Shimmer233/2026NUEDC-H/视觉/orangepi5b_vision_only/config/track_calibration.reference.jpg

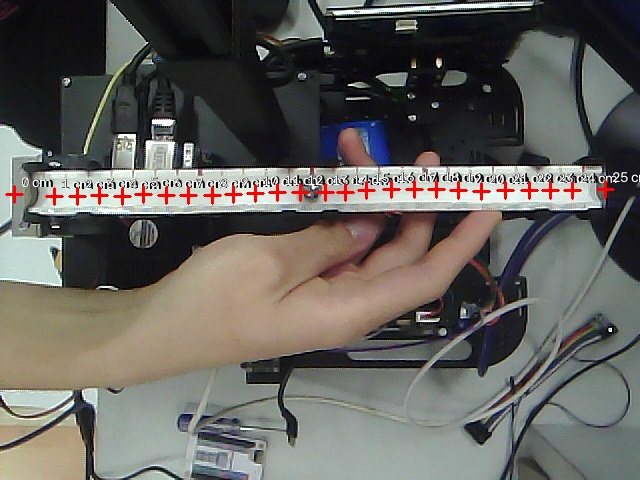
视觉/orangepi5b_vision_only/config/track_calibration.reference.jpg
