Shimmer233/2026NUEDC-H/README.md

# 2026NUEDC-H
2026年全国大学生电子设计竞赛H题的实现方案，包含结构文件，单片机程序，视觉程序
