Shimmer233/2026NUEDC-H/视觉/orangepi5b_vision_only/board/requirements-board.txt

numpy>=1.24,<2.0
opencv-python>=4.8
PyYAML>=6.0
# Install the supplied Rockchip RKNNLite wheel separately on RK3588/aarch64.
