Shimmer233/2026NUEDC-H/程序/README.txt

xunxian_1_new_drive_only_motor.zip 是控制循迹底盘的3507的程序
xunxian_1_new_drive_8_2_23.zip 是控制步进电机的3507的程序
