Shimmer233/2026NUEDC-H/005H038/c96c47cec39e12cd0c512a1ca953ea7d.jpg

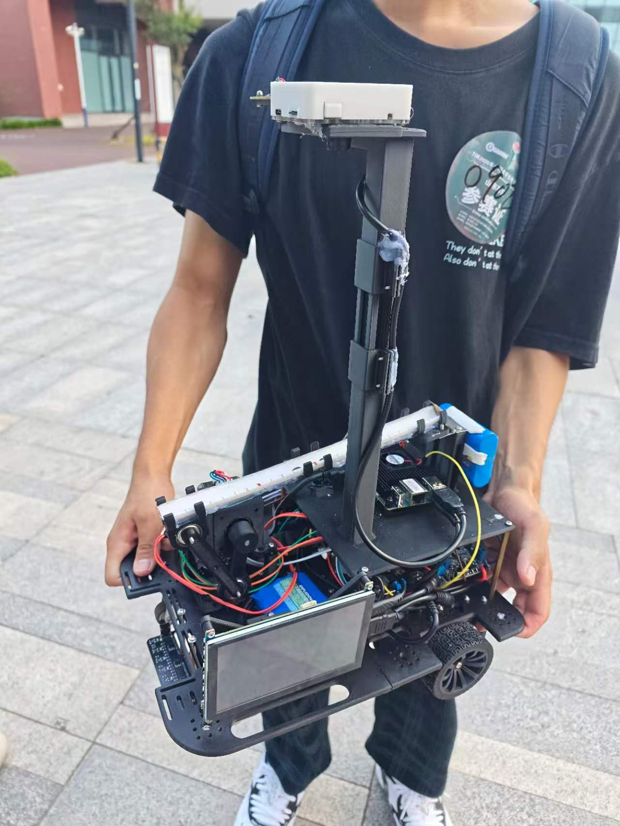
005H038/c96c47cec39e12cd0c512a1ca953ea7d.jpg
