Shimmer233/2026NUEDC-H/视觉/steel_ball_pipeline/artifacts/yolov5n/PR_curve.png

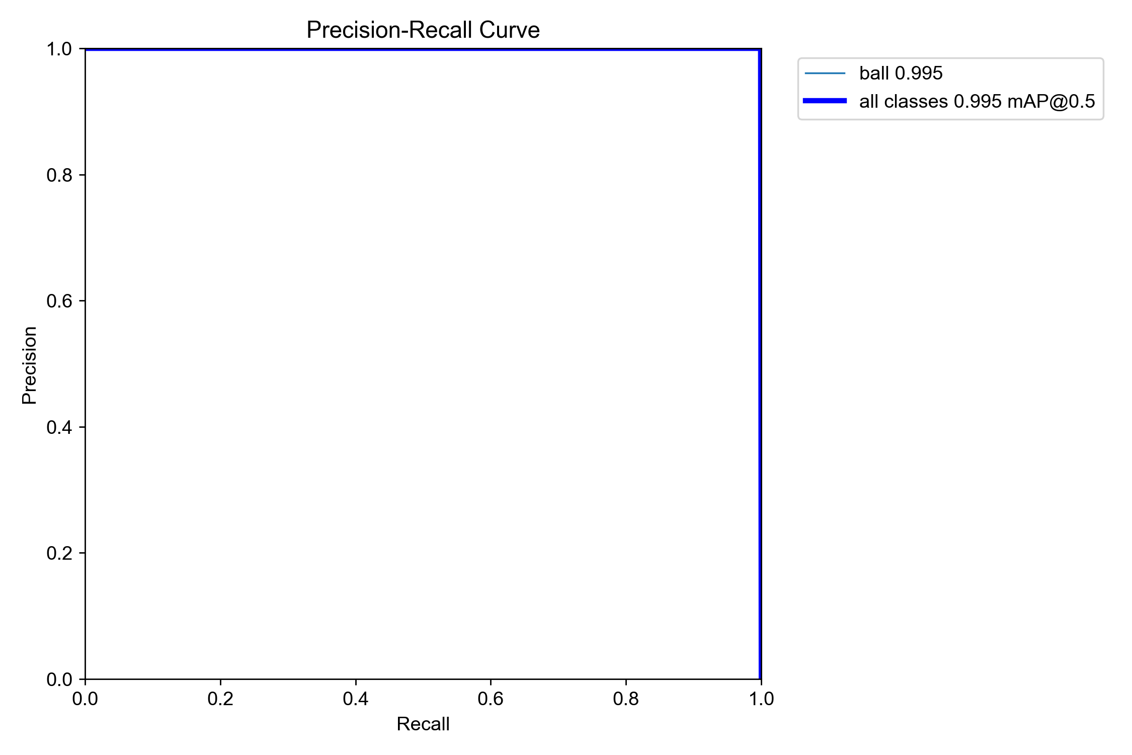
视觉/steel_ball_pipeline/artifacts/yolov5n/PR_curve.png
