Shimmer233/2026NUEDC-H/视觉/steel_ball_pipeline/artifacts/yolov5n_v4_incremental/video_regression/worst_ball_frames.jpg

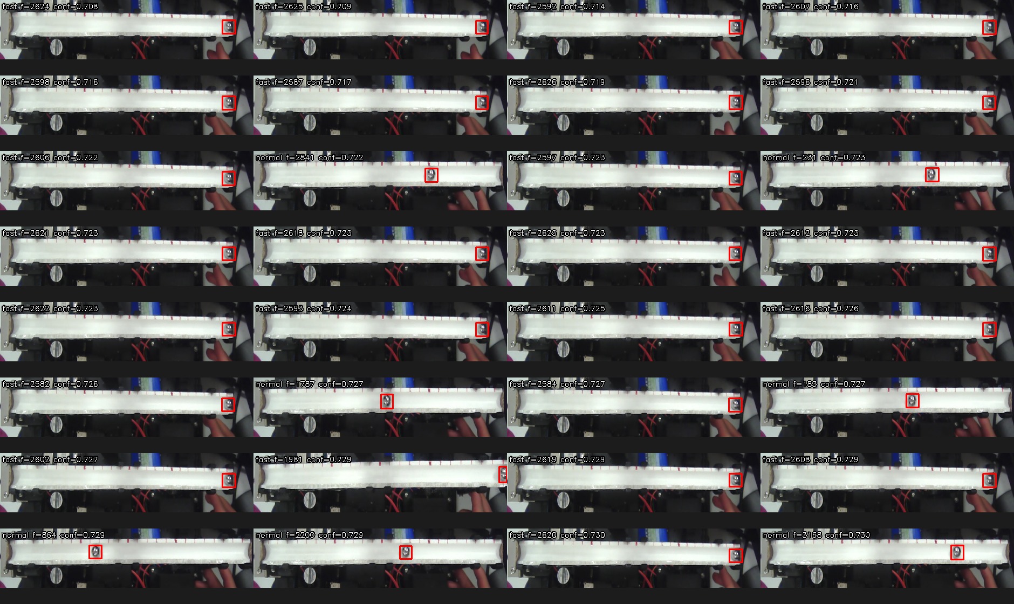
视觉/steel_ball_pipeline/artifacts/yolov5n_v4_incremental/video_regression/worst_ball_frames.jpg
