Shimmer233/2026NUEDC-H/视觉/steel_ball_pipeline/runs/final_acceptance_yolov5n_adapted_v3_480x320/worst_ball_frames.jpg

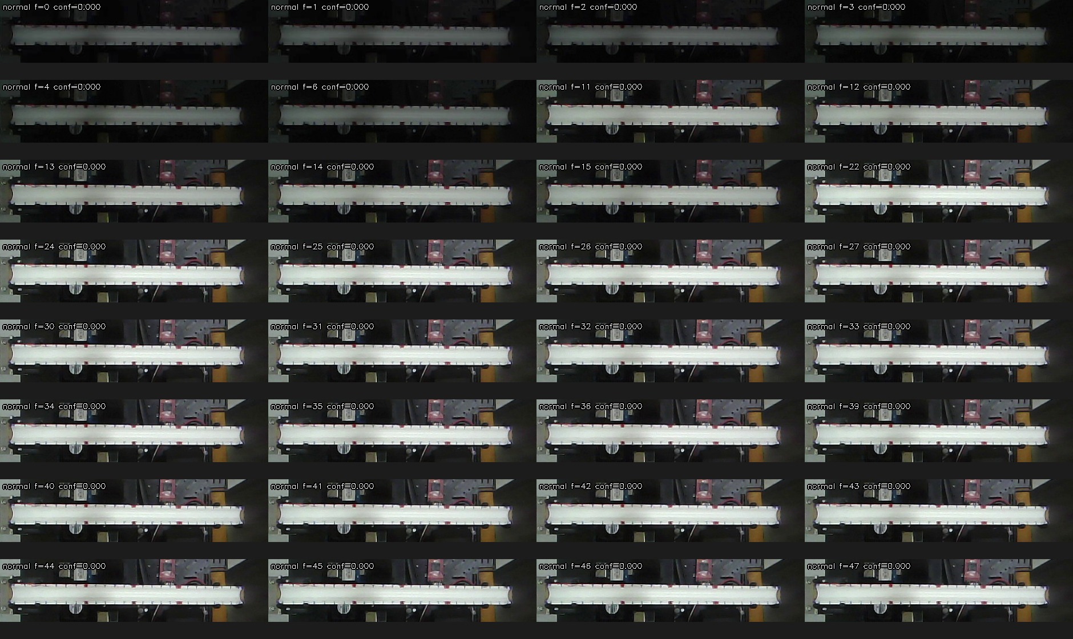
视觉/steel_ball_pipeline/runs/final_acceptance_yolov5n_adapted_v3_480x320/worst_ball_frames.jpg
