Shimmer233/2026NUEDC-H/视觉/steel_ball_pipeline/runs/train/steel_ball_yolov5n_seed42_20260731_002451/confusion_matrix.png

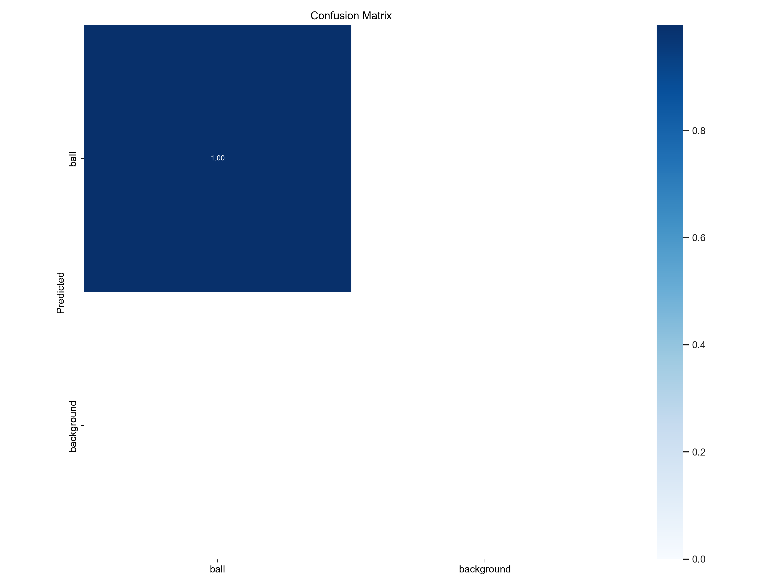
视觉/steel_ball_pipeline/runs/train/steel_ball_yolov5n_seed42_20260731_002451/confusion_matrix.png
