Shimmer233/2026NUEDC-H/视觉/steel_ball_pipeline/runs/train/steel_ball_yolov5n_seed42_20260731_012030/labels.jpg

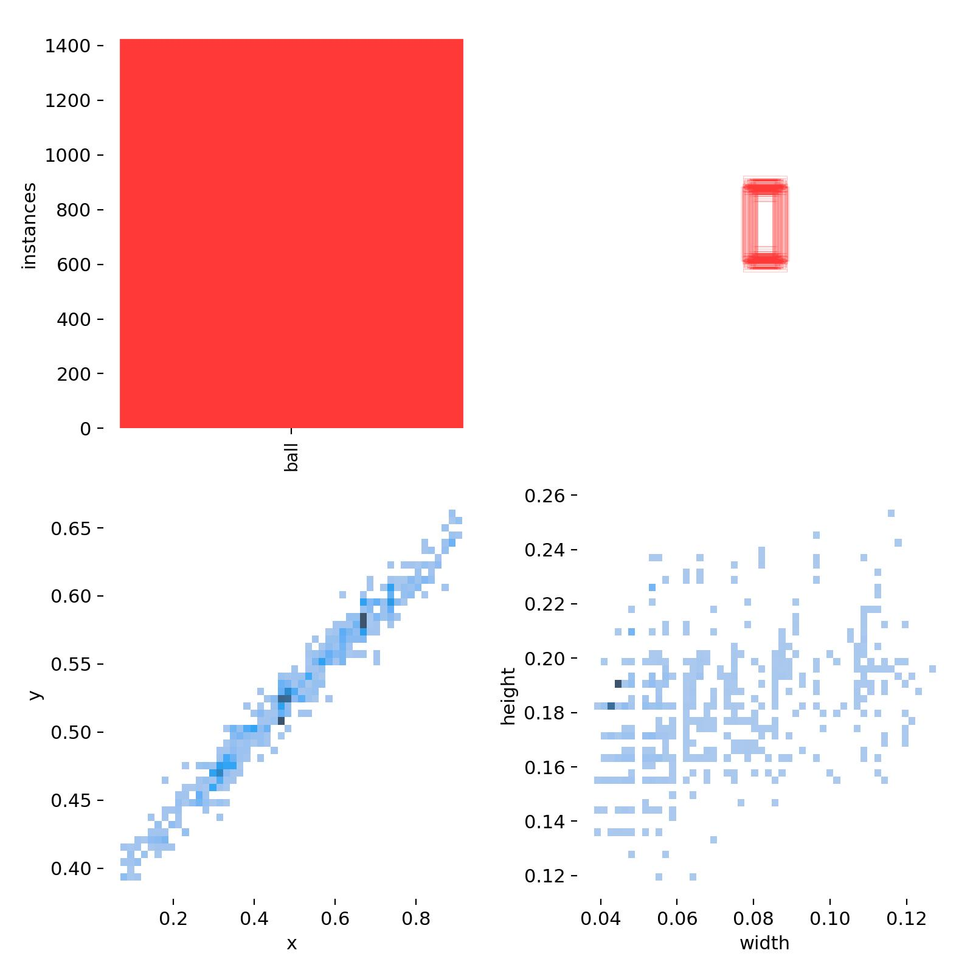
视觉/steel_ball_pipeline/runs/train/steel_ball_yolov5n_seed42_20260731_012030/labels.jpg
