Shimmer233/2026NUEDC-H/视觉/steel_ball_pipeline/runs/train/steel_ball_yolov5n_v4_incremental_seed42/F1_curve.png

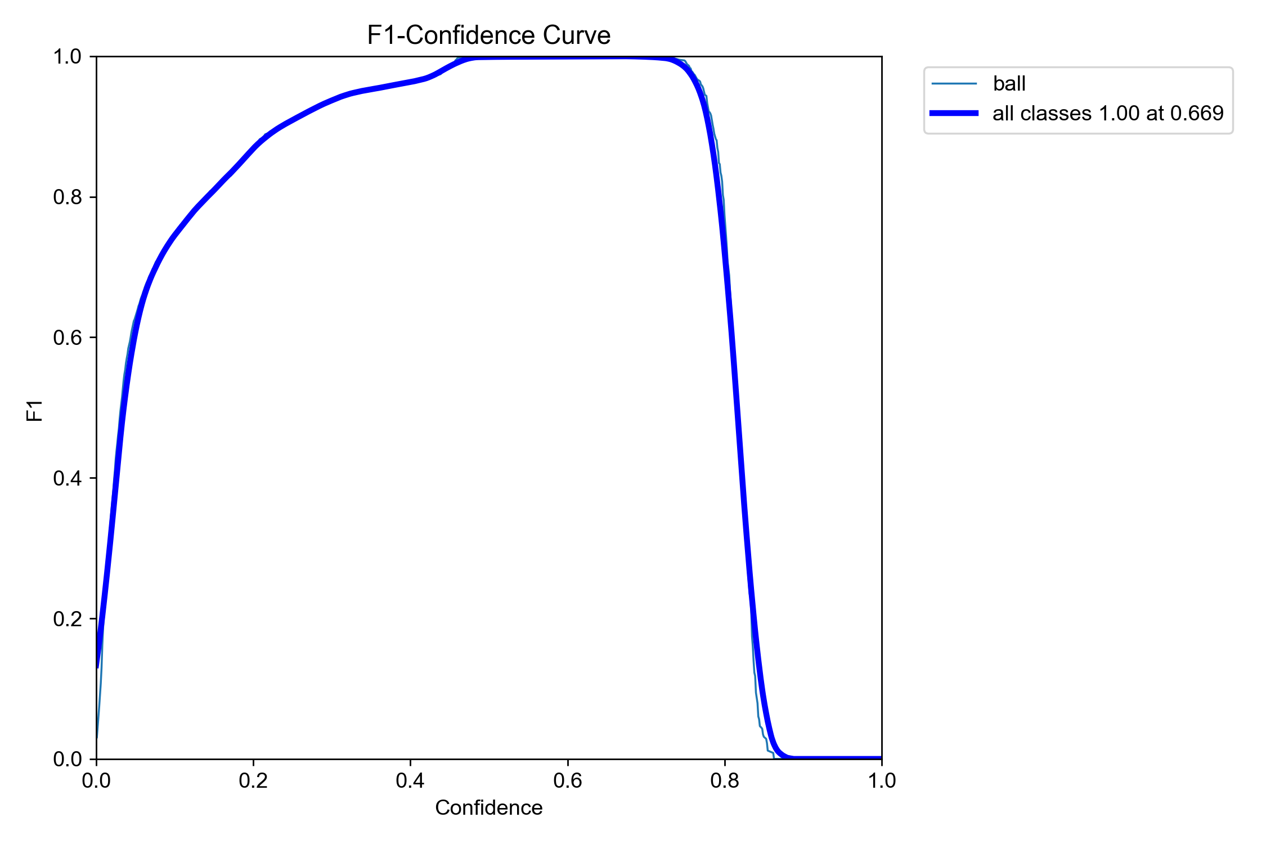
视觉/steel_ball_pipeline/runs/train/steel_ball_yolov5n_v4_incremental_seed42/F1_curve.png
