Shimmer233/2026NUEDC-H/视觉/steel_ball_pipeline/runs/train/steel_ball_yolov5s_seed42_20260731_014210/F1_curve.png

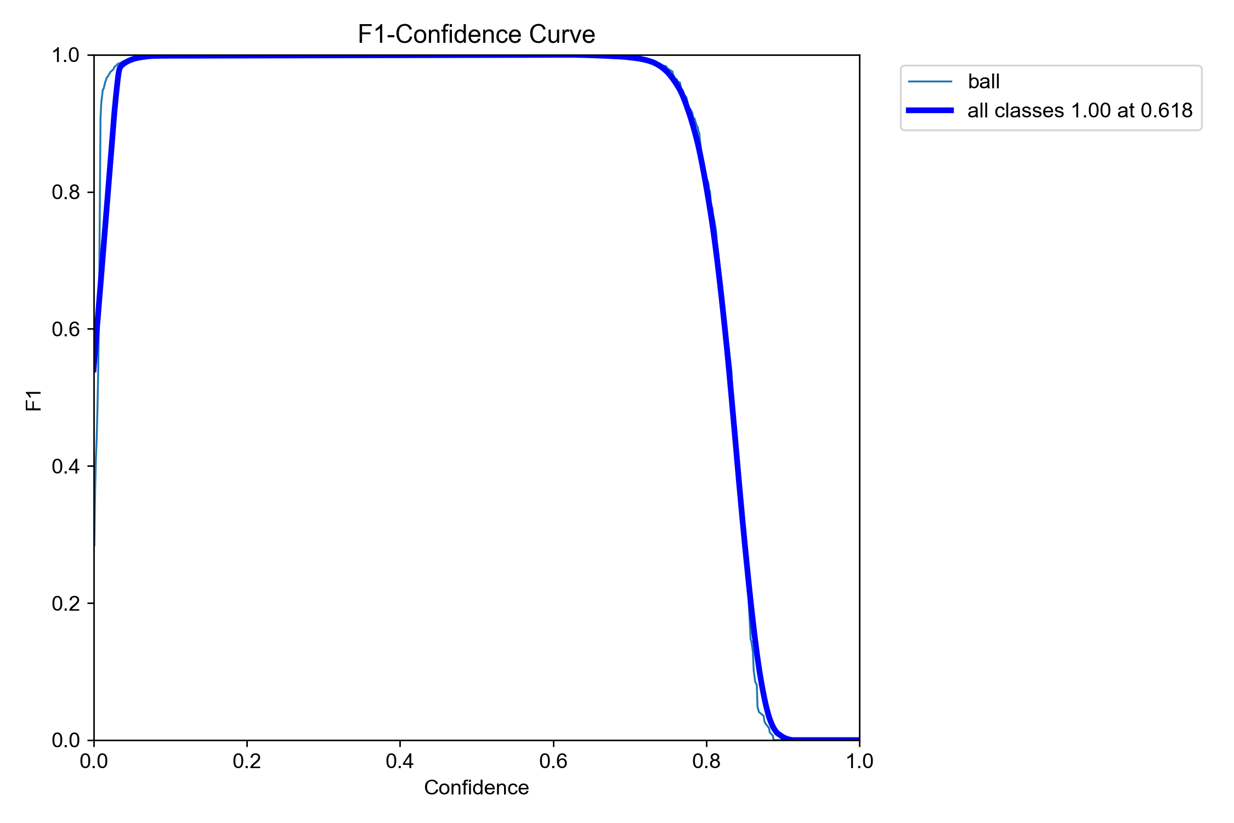
视觉/steel_ball_pipeline/runs/train/steel_ball_yolov5s_seed42_20260731_014210/F1_curve.png
