Shimmer233/2026NUEDC-H/视觉/steel_ball_pipeline/runs/video_acceptance/top_empty_detections.jpg

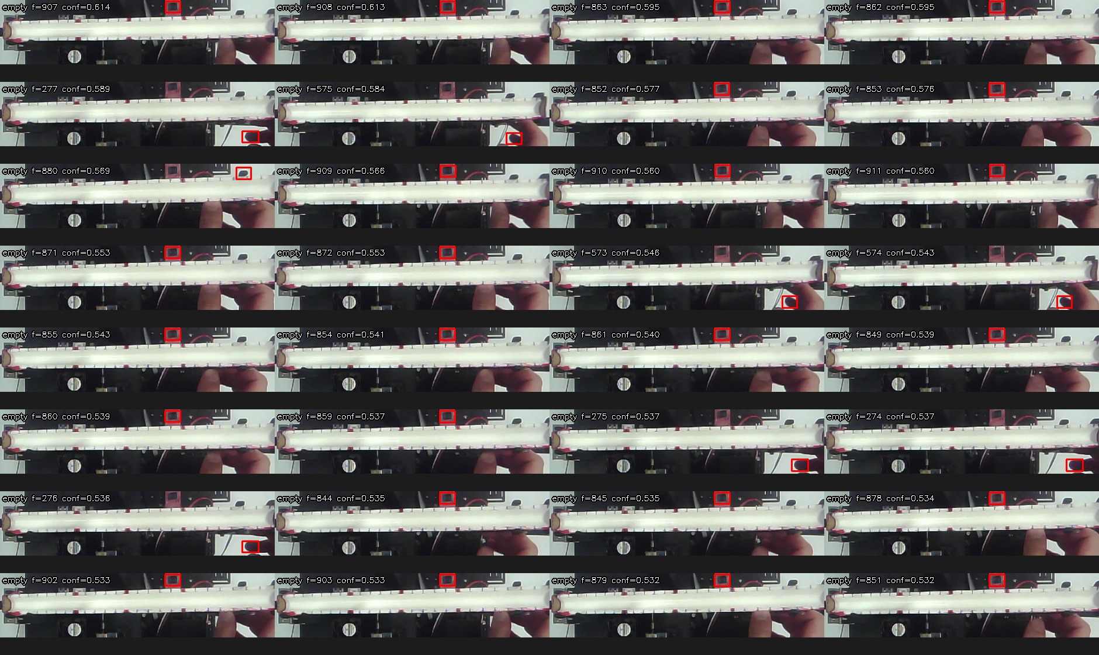
视觉/steel_ball_pipeline/runs/video_acceptance/top_empty_detections.jpg
