Shimmer233/2026NUEDC-H/视觉/steel_ball_pipeline/runs/video_acceptance/worst_ball_frames.jpg

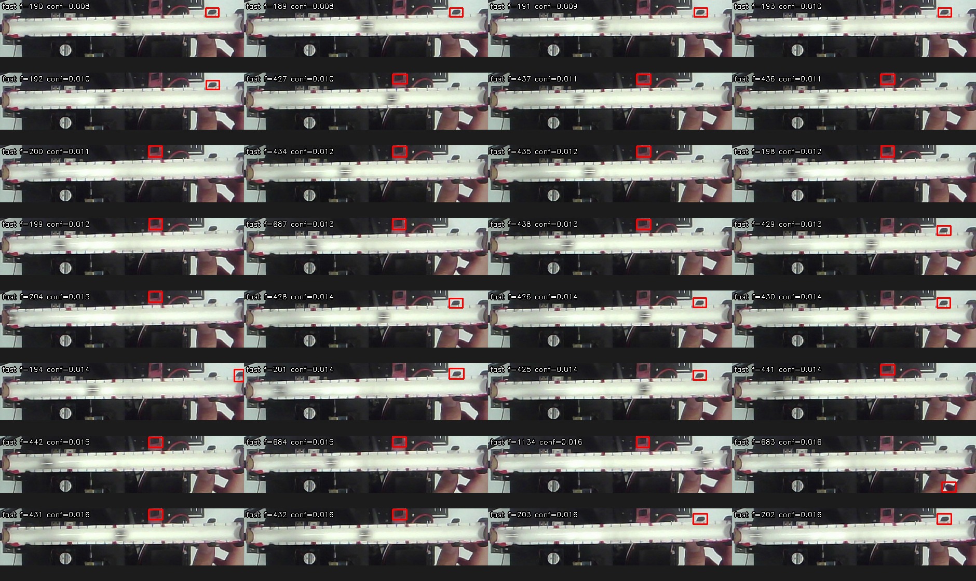
视觉/steel_ball_pipeline/runs/video_acceptance/worst_ball_frames.jpg
