Shimmer233/2026NUEDC-H/视觉/steel_ball_pipeline/runs/video_acceptance_yolov5s_highblur/top_empty_detections.jpg

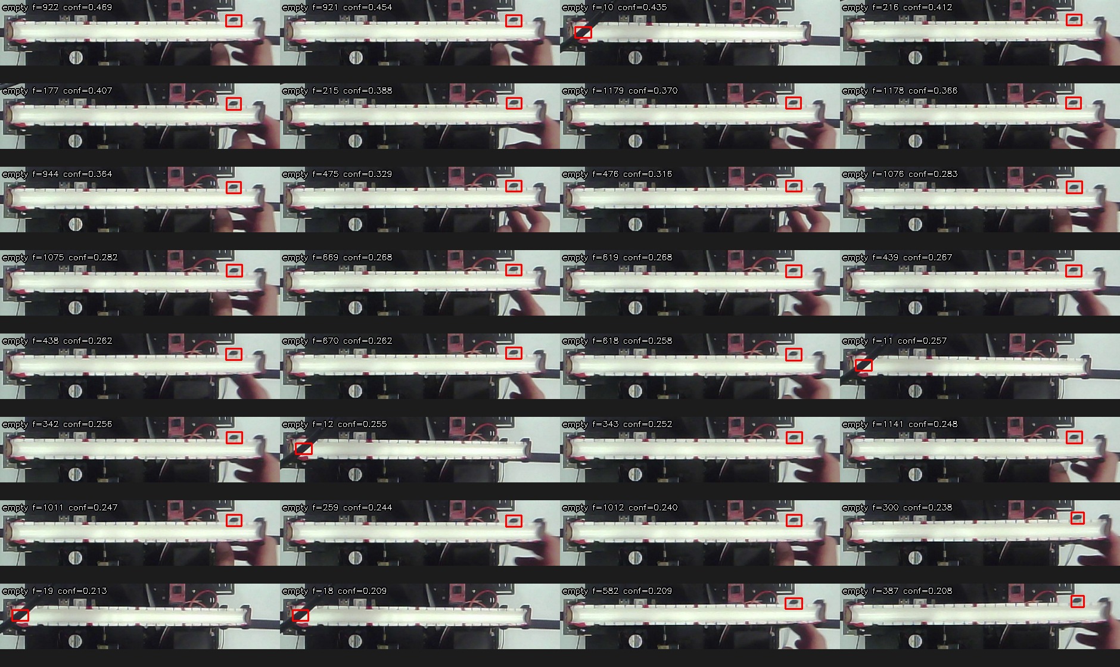
视觉/steel_ball_pipeline/runs/video_acceptance_yolov5s_highblur/top_empty_detections.jpg
