Shimmer233/2026NUEDC-H/结构/平衡/臂2.SLDPRT

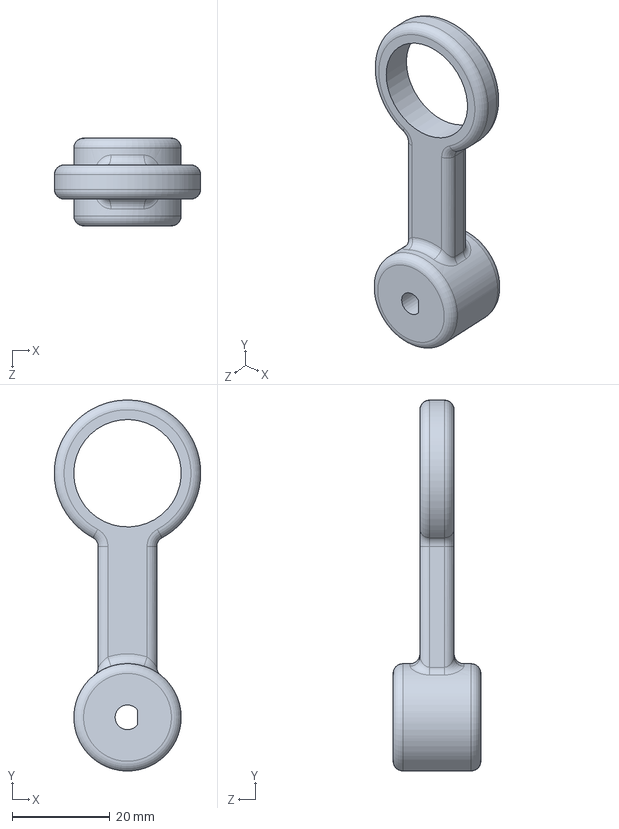
[picture p45: CAD file, 2026-10-08]
结构/平衡/臂2.SLDPRT
30.0 x 76.0 x 18.0 mm
