Shimmer233/2026NUEDC-H/结构/车模/右下.SLDPRT

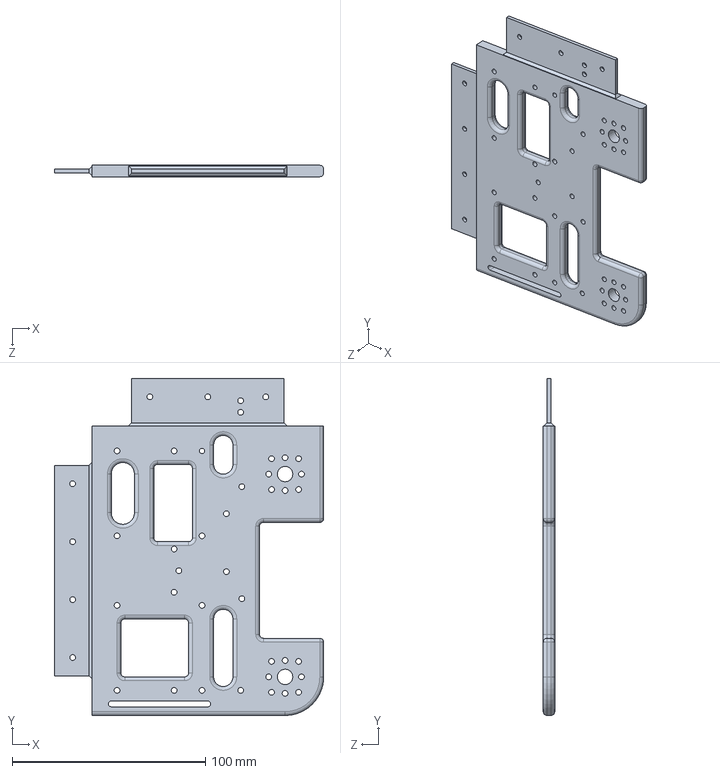
[picture p46: CAD file, 2026-10-08]
结构/车模/右下.SLDPRT
139.5 x 174.5 x 6.00 mm
