Shimmer233/2026NUEDC-H/结构/平衡/补.SLDPRT

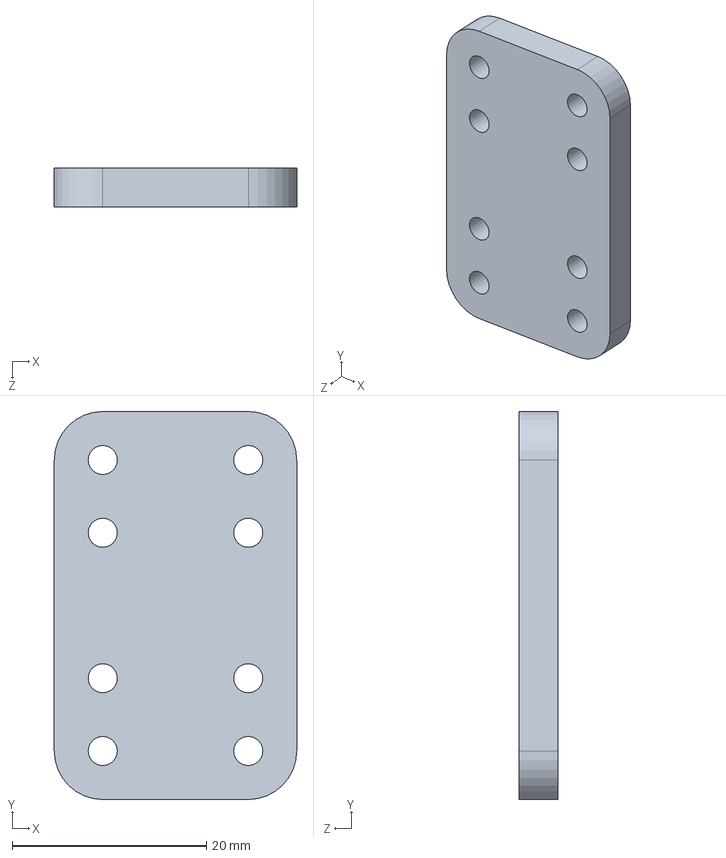
[picture p47: CAD file, 2026-10-08]
结构/平衡/补.SLDPRT
25.0 x 40.0 x 4.00 mm
