Shimmer233/2026NUEDC-H/结构/车模/中心.SLDPRT

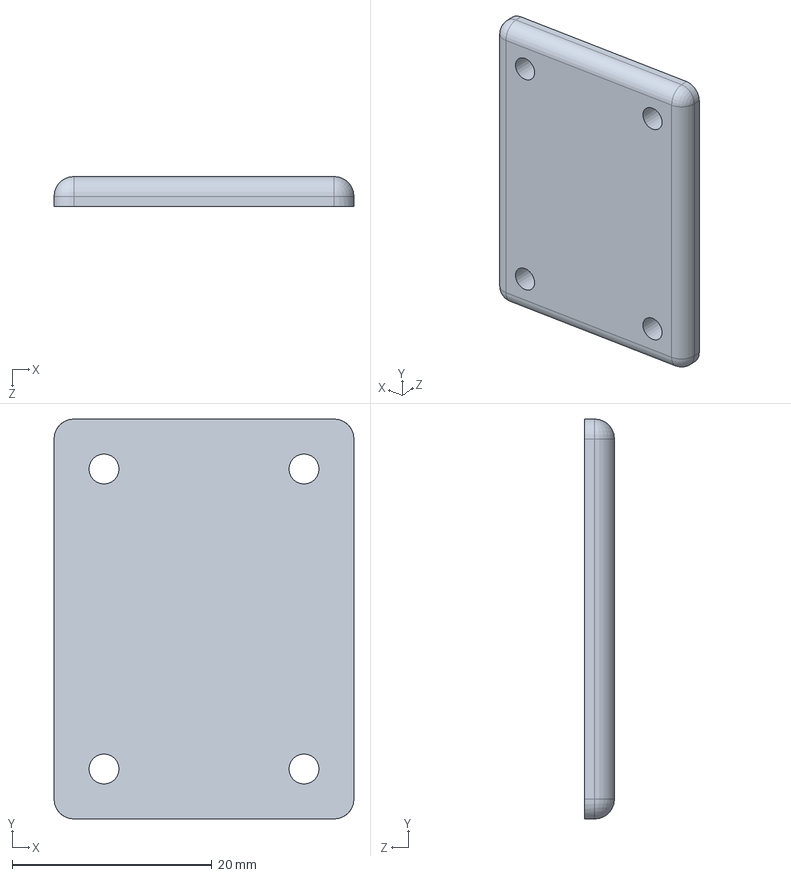
[picture p48: CAD file, 2026-10-08]
结构/车模/中心.SLDPRT
30.0 x 40.0 x 3.00 mm
