Shimmer233/2026NUEDC-H/结构/平衡/夹杆.SLDPRT

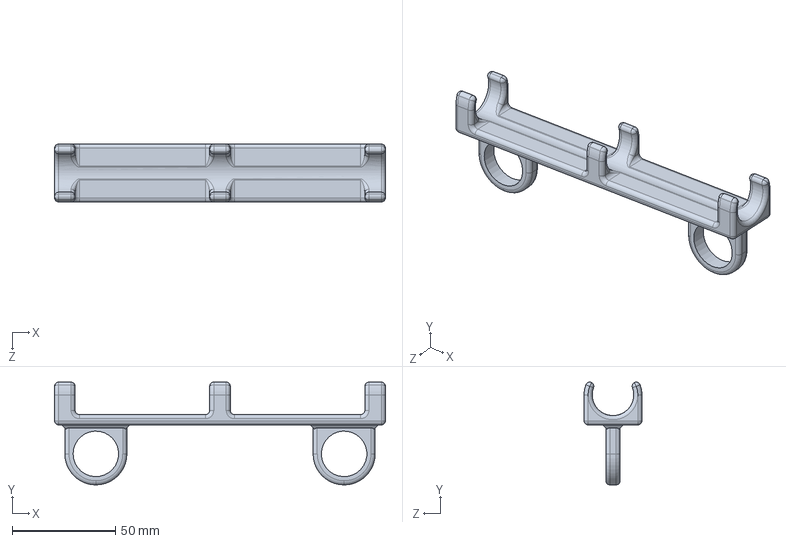
[picture p49: CAD file, 2026-10-08]
结构/平衡/夹杆.SLDPRT
160.0 x 49.7 x 28.0 mm
