Shimmer233/2026NUEDC-H/结构/车模/打印.3mf

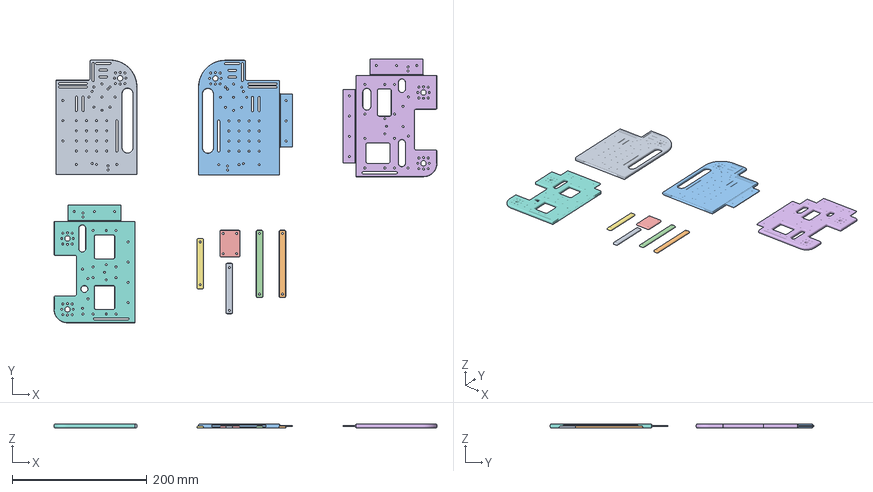
[picture p50: CAD file, 2026-10-08]
结构/车模/打印.3mf
568.2 x 391.1 x 6.00 mm
右上.STL
横梁.STL x 2
左上.STL
中心.STL
右下.STL
纵梁.STL x 2
左下.STL
