Shimmer233/2026NUEDC-H/结构/平衡/支架.SLDPRT

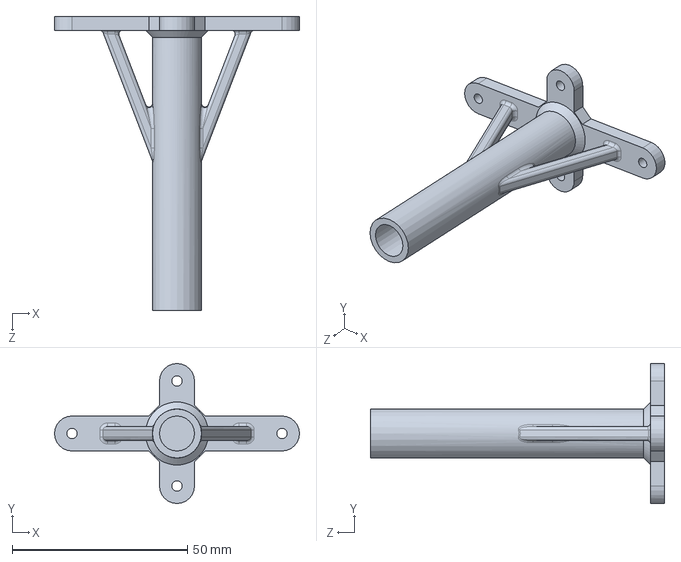
[picture p51: CAD file, 2026-10-08]
结构/平衡/支架.SLDPRT
70.0 x 40.0 x 84.0 mm
