Shimmer233/2026NUEDC-H/结构/车模/横梁.SLDPRT

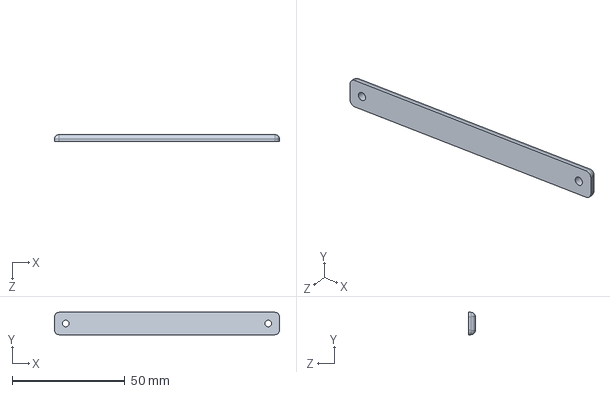
[picture p52: CAD file, 2026-10-08]
结构/车模/横梁.SLDPRT
100.0 x 10.0 x 3.00 mm
