Shimmer233/2026NUEDC-H/结构/平衡/补屏幕.SLDPRT

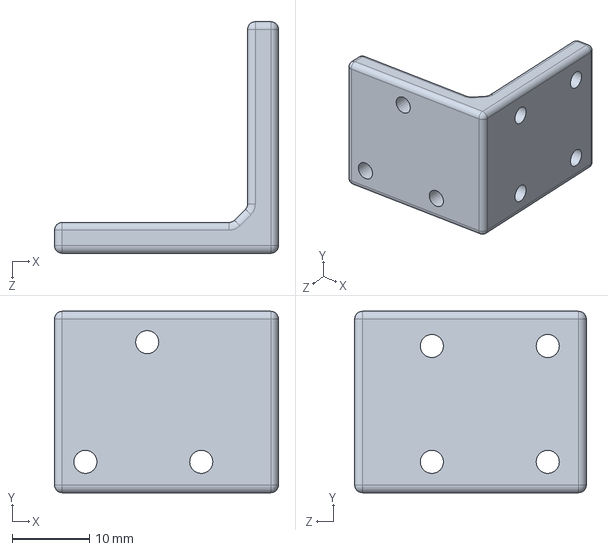
[picture p53: CAD file, 2026-10-08]
结构/平衡/补屏幕.SLDPRT
29.0 x 23.5 x 30.0 mm
