Shimmer233/2026NUEDC-H/结构/车模/左上.SLDPRT

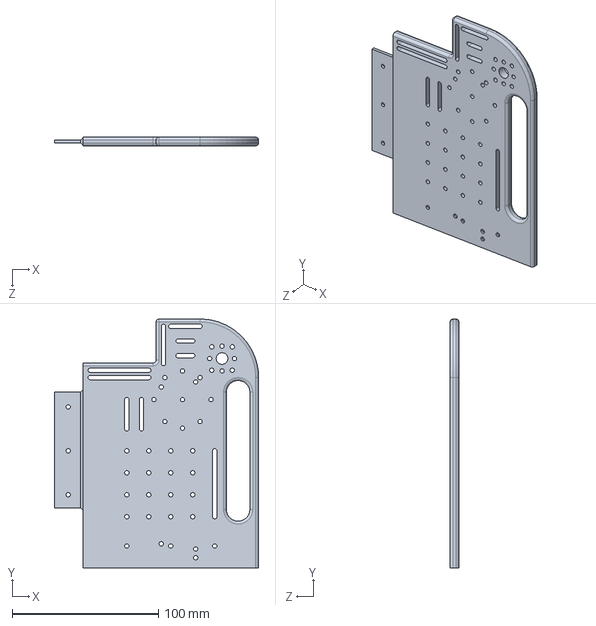
[picture p54: CAD file, 2026-10-08]
结构/车模/左上.SLDPRT
139.5 x 170.0 x 6.00 mm
