Shimmer233/2026NUEDC-H/结构/平衡/电机壳.SLDPRT

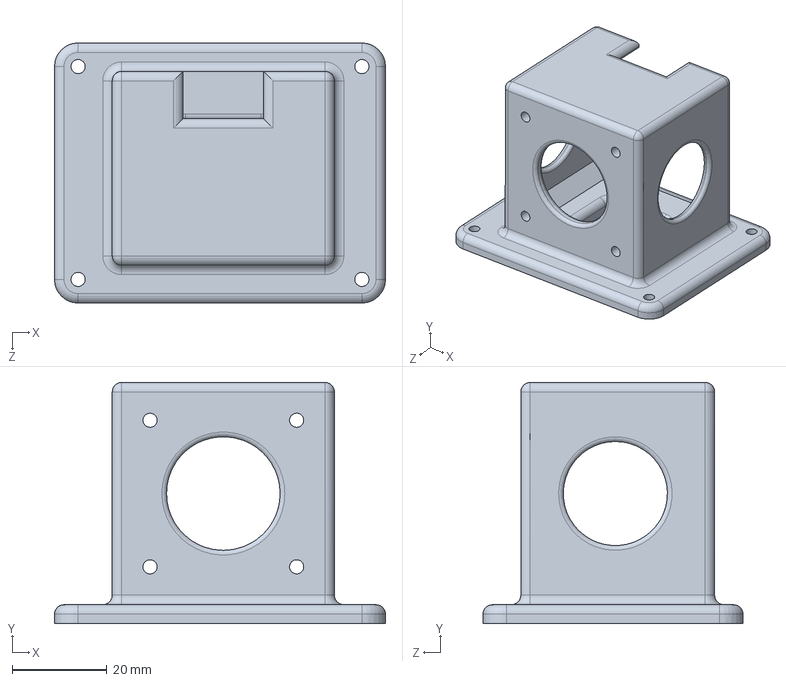
[picture p55: CAD file, 2026-10-08]
结构/平衡/电机壳.SLDPRT
70.0 x 51.0 x 55.0 mm
