Shimmer233/2026NUEDC-H/结构/车模/右上.SLDPRT

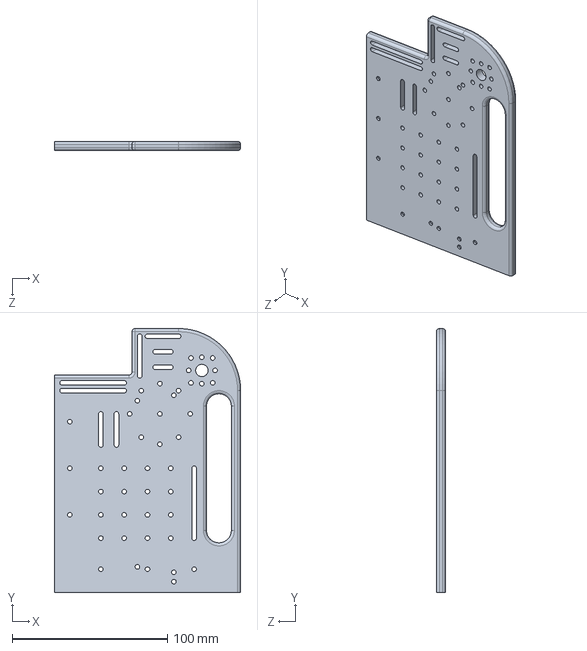
[picture p56: CAD file, 2026-10-08]
结构/车模/右上.SLDPRT
120.0 x 170.0 x 6.00 mm
