Shimmer233/2026NUEDC-H/结构/平衡/陀螺仪垂直板.SLDPRT

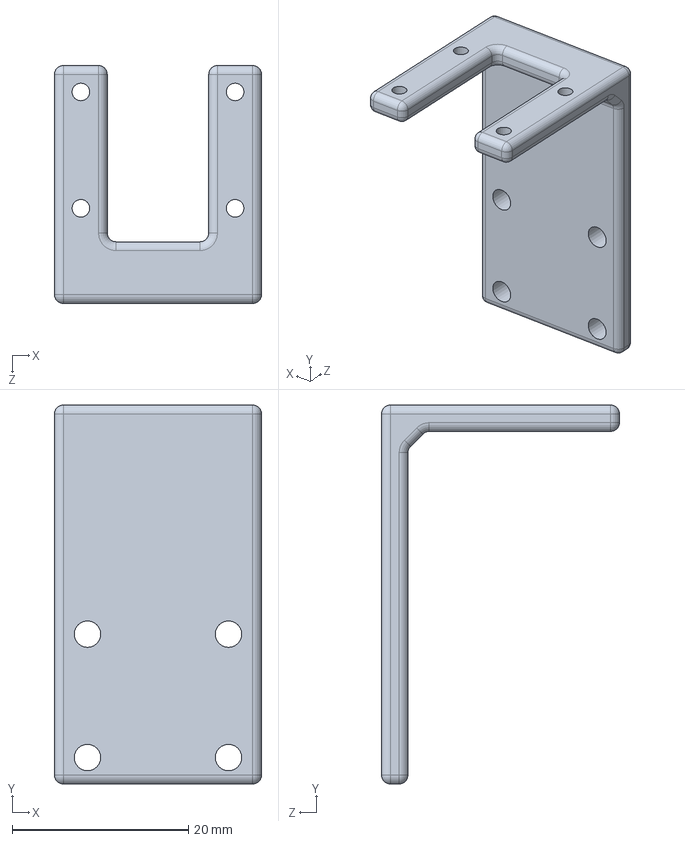
[picture p57: CAD file, 2026-10-08]
结构/平衡/陀螺仪垂直板.SLDPRT
23.5 x 43.0 x 27.0 mm
