Shimmer233/2026NUEDC-H/结构/车模/左下.SLDPRT

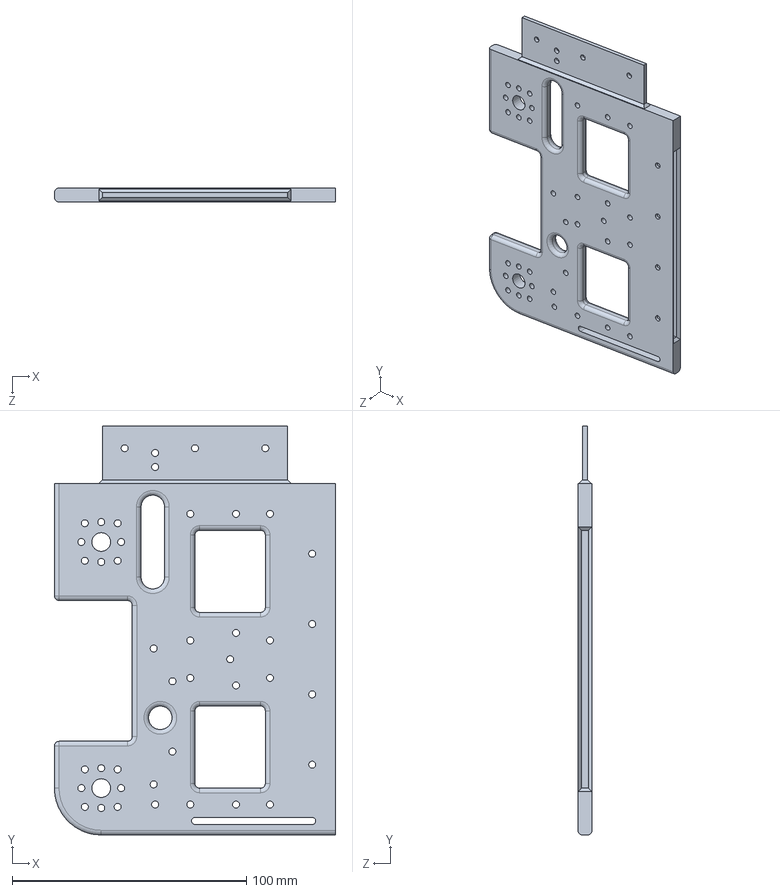
[picture p58: CAD file, 2026-10-08]
结构/车模/左下.SLDPRT
120.0 x 174.5 x 6.00 mm
