Shimmer233/2026NUEDC-H/结构/平衡/臂3.SLDPRT

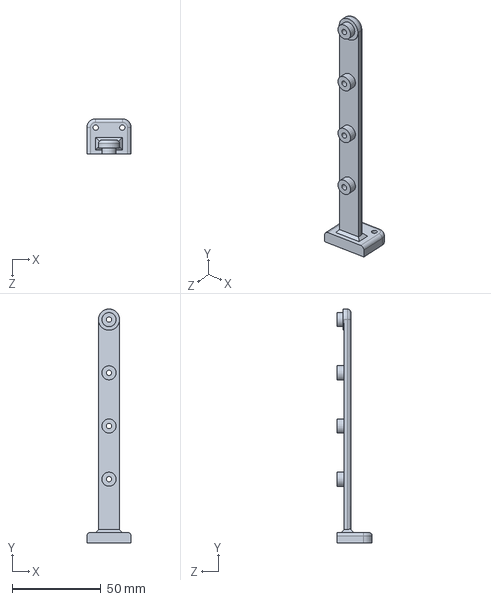
[picture p59: CAD file, 2026-10-08]
结构/平衡/臂3.SLDPRT
25.0 x 132.0 x 20.0 mm
