Shimmer233/2026NUEDC-H/结构/车模/纵梁.SLDPRT

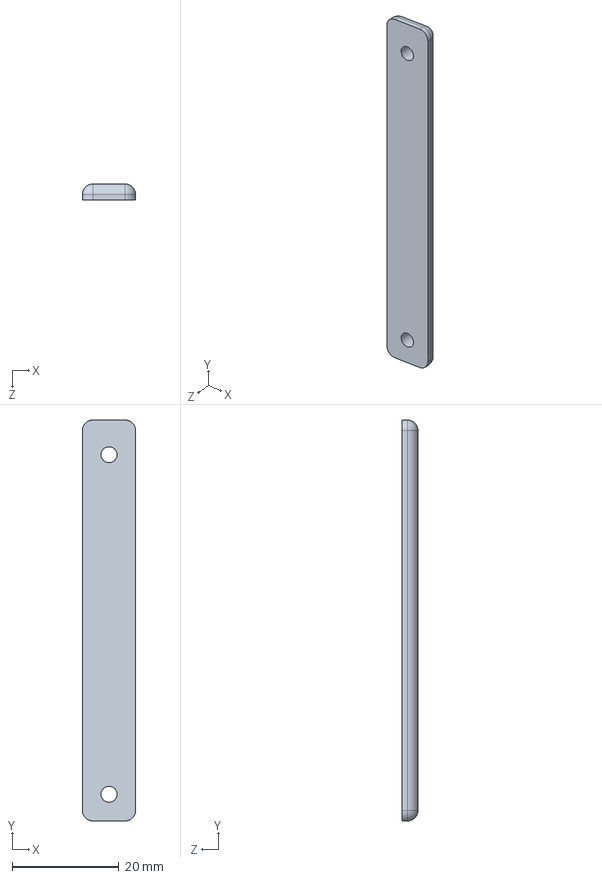
[picture p60: CAD file, 2026-10-08]
结构/车模/纵梁.SLDPRT
10.0 x 75.0 x 3.00 mm
