Shimmer233/2026NUEDC-H/结构/平衡/连杆器.SLDPRT

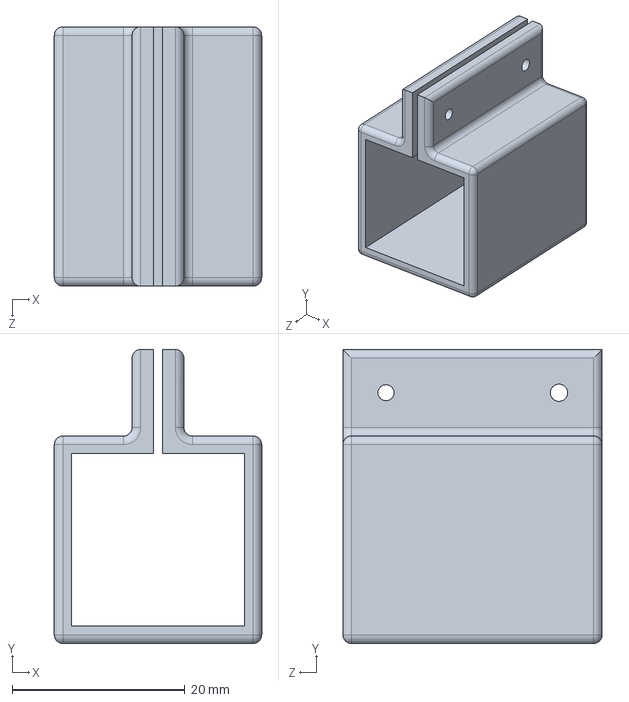
[picture p61: CAD file, 2026-10-08]
结构/平衡/连杆器.SLDPRT
24.0 x 34.0 x 30.0 mm
