Shimmer233/2026NUEDC-H/结构/平衡/补支架.SLDPRT

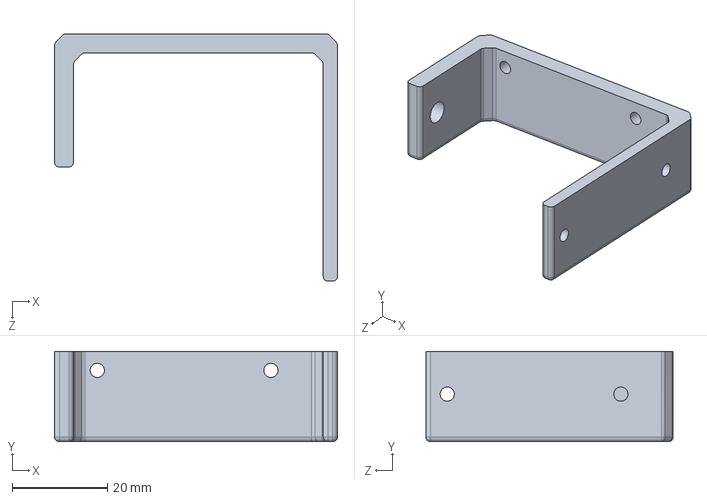
[picture p62: CAD file, 2026-10-08]
结构/平衡/补支架.SLDPRT
59.5 x 19.0 x 52.0 mm
