Shimmer233/2026NUEDC-H/结构/平衡/屏幕.SLDPRT

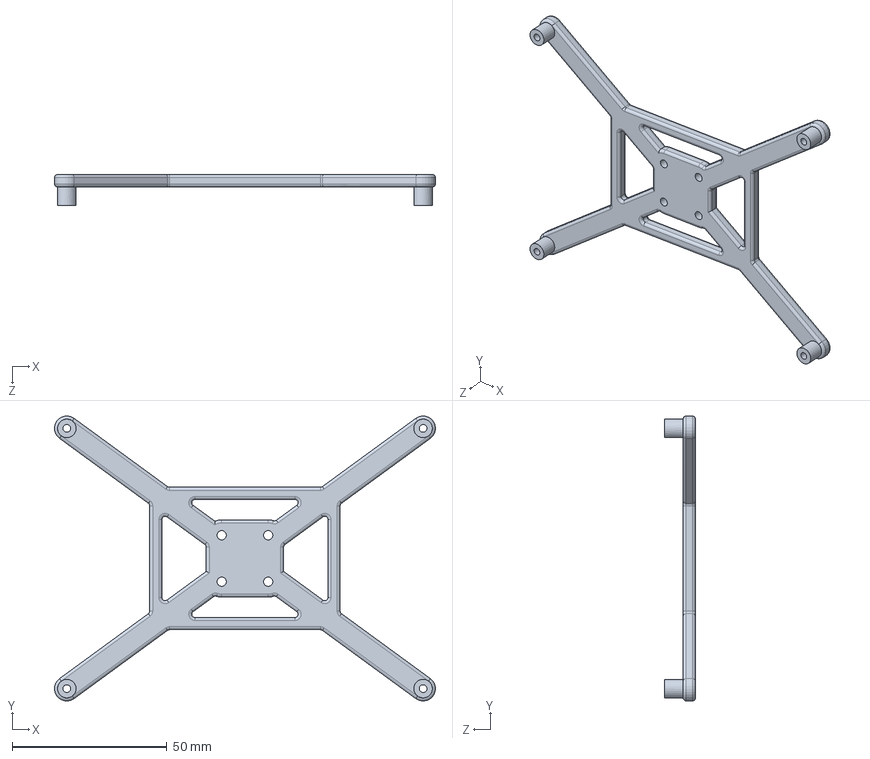
[picture p63: CAD file, 2026-10-08]
结构/平衡/屏幕.SLDPRT
123.0 x 92.0 x 10.0 mm
