Shimmer233/2026NUEDC-H/结构/平衡/连接器28.SLDPRT

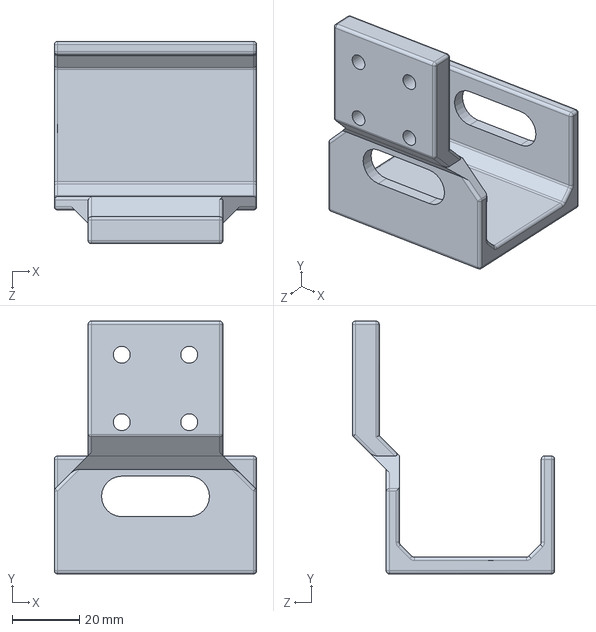
[picture p64: CAD file, 2026-10-08]
结构/平衡/连接器28.SLDPRT
60.0 x 75.0 x 60.0 mm
