Shimmer233/2026NUEDC-H/结构/平衡/补电机壳(1).SLDPRT

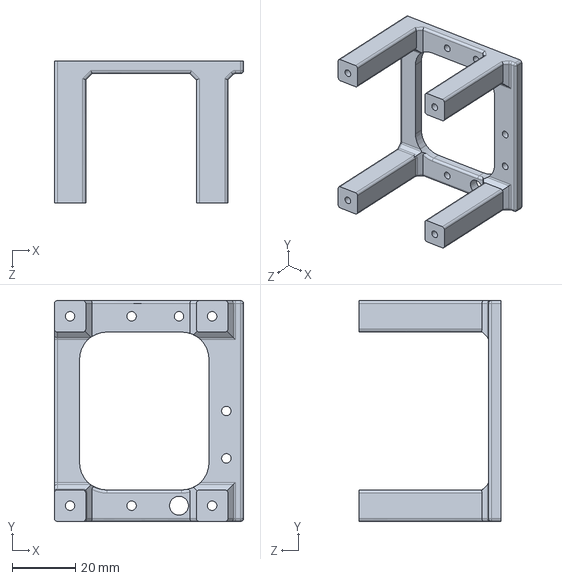
[picture p65: CAD file, 2026-10-08]
结构/平衡/补电机壳(1).SLDPRT
60.0 x 70.0 x 45.0 mm
