Shimmer233/2026NUEDC-H/结构/平衡/夹子.SLDPRT

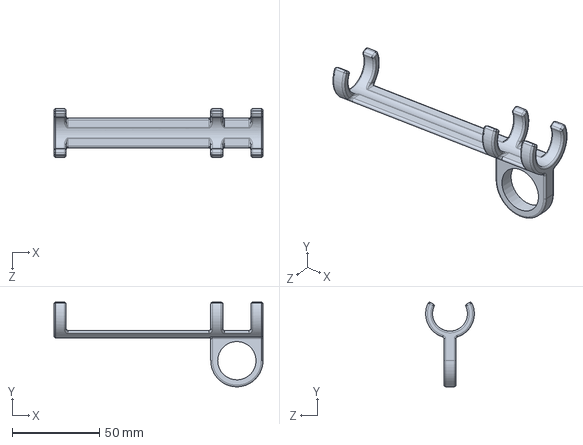
[picture p66: CAD file, 2026-10-08]
结构/平衡/夹子.SLDPRT
120.0 x 48.6 x 28.0 mm
