Shimmer233/2026NUEDC-H/结构/平衡/固定端.SLDPRT

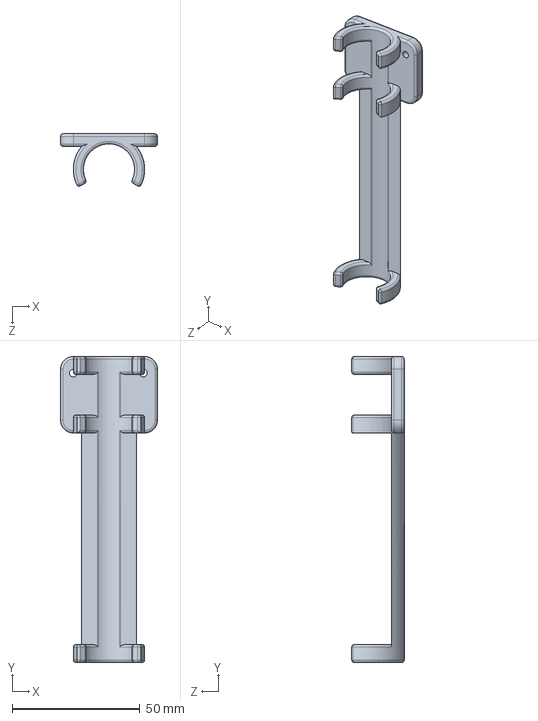
[picture p67: CAD file, 2026-10-08]
结构/平衡/固定端.SLDPRT
38.0 x 120.0 x 20.6 mm
