Shimmer233/2026NUEDC-H/结构/平衡/臂1.SLDPRT

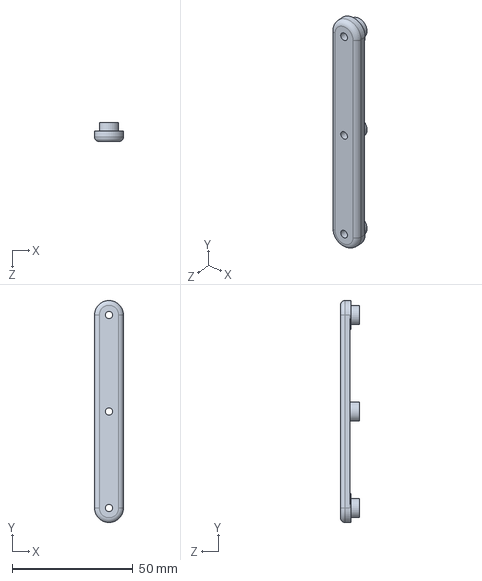
[picture p68: CAD file, 2026-10-08]
结构/平衡/臂1.SLDPRT
12.0 x 92.0 x 8.00 mm
