Shimmer233/2026NUEDC-H/结构/平衡/连接头.SLDPRT

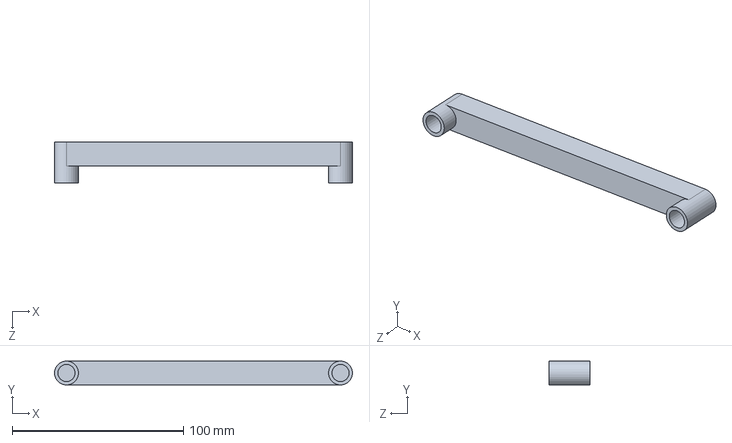
[picture p69: CAD file, 2026-10-08]
结构/平衡/连接头.SLDPRT
174.0 x 14.0 x 24.0 mm
