Shimmer233/2026NUEDC-H/(list of files, cad)

Other CAD files:
结构/平衡/固定端.STL
结构/平衡/夹子(3).SLDPRT
结构/平衡/夹子.STL
结构/平衡/夹杆.STL
结构/平衡/屏幕.STL
结构/平衡/支架.STL
结构/平衡/电机壳.STL
结构/平衡/臂1.STL
结构/平衡/臂2.STL
结构/平衡/臂3.STL
结构/平衡/补.STL
结构/平衡/补屏幕.STL
结构/平衡/补支架.STL
结构/平衡/补电机壳(1).STL
结构/平衡/连接头.STL
结构/平衡/连杆器.STL
结构/平衡/陀螺仪垂直板.STL
结构/车模/中心.STL
结构/车模/右上.STL
结构/车模/右下.STL
结构/车模/左上.STL
结构/车模/左下.STL
结构/车模/横梁.STL
结构/车模/纵梁.STL
