Shimmer233/2026NUEDC-H/视觉/orangepi5b_vision_only/runs/manual_v4/20260802T093304Z_normal/trajectory.csv

timestamp_ns | frame_id | detected | confidence | x_px | y_px | s_cm | velocity_cm_s | predicted
1785663186162894192 | 0 | 0 |  |  |  |  |  | 0
1785663186195471072 | 1 | 0 |  |  |  |  |  | 0
1785663186213271310 | 2 | 0 |  |  |  |  |  | 0
1785663186233227526 | 3 | 1 | 0.050980 | 554.500 | 201.500 | 23.50610 | 0.00000 | 0
1785663186255608051 | 4 | 0 |  |  |  | 23.50610 | 0.00000 | 1
1785663186269110331 | 5 | 1 | 0.039216 | 552.500 | 197.500 | 23.42830 | -1.95521 | 0
1785663186283273522 | 6 | 0 | 0.039216 | 552.500 | 197.500 | 23.40060 | -1.95521 | 1
1785663186304358477 | 7 | 0 |  |  |  | 23.35938 | -1.95521 | 1
1785663186321459888 | 8 | 1 | 0.047059 | 554.500 | 195.500 | 23.37242 | -1.33006 | 0
1785663186341000191 | 9 | 0 |  |  |  | 23.34643 | -1.33006 | 1
1785663186360934532 | 10 | 1 | 0.039216 | 555.500 | 204.500 | 23.46110 | 0.21859 | 0
1785663186382980519 | 11 | 1 | 0.078431 | 553.500 | 193.500 | 23.46804 | 0.24190 | 0
1785663186402227700 | 12 | 0 |  |  |  | 23.47269 | 0.24190 | 1
1785663186424329019 | 13 | 1 | 0.054902 | 554.500 | 197.500 | 23.49800 | 0.46144 | 0
1785663186440861686 | 14 | 0 | 0.054902 | 554.500 | 197.500 | 23.50563 | 0.46144 | 1
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
