Shimmer233/2026NUEDC-H/视觉/orangepi5b_vision_only/runs/manual_v4/20260802T093406Z_fast/trajectory.csv

timestamp_ns | frame_id | detected | confidence | x_px | y_px | s_cm | velocity_cm_s | predicted
1785663247885931529 | 0 | 0 |  |  |  |  |  | 0
1785663247941846591 | 1 | 0 |  |  |  |  |  | 0
1785663247959887159 | 2 | 0 |  |  |  |  |  | 0
1785663247978147642 | 3 | 0 |  |  |  |  |  | 0
1785663247999327971 | 4 | 0 |  |  |  |  |  | 0
1785663248017063167 | 5 | 0 |  |  |  |  |  | 0
1785663248038067914 | 6 | 1 | 0.043137 | 554.500 | 201.500 | 23.50610 | 0.00000 | 0
1785663248062853915 | 7 | 1 | 0.047059 | 549.500 | 201.500 | 23.32367 | -5.98003 | 0
1785663248080323697 | 8 | 1 | 0.105882 | 555.500 | 200.500 | 23.27479 | -4.48328 | 0
1785663248105524652 | 9 | 1 | 0.039216 | 556.500 | 201.500 | 23.32941 | -1.23060 | 0
1785663248120199713 | 10 | 1 | 0.054902 | 552.500 | 197.500 | 23.34406 | -0.67387 | 0
1785663248142025201 | 11 | 0 | 0.054902 | 552.500 | 197.500 | 23.32935 | -0.67387 | 1
1785663248160651431 | 12 | 1 | 0.031373 | 554.500 | 202.500 | 23.42100 | 0.63424 | 0
1785663248180587813 | 13 | 1 | 0.066667 | 560.500 | 198.500 | 23.61081 | 2.72663 | 0
1785663248200703569 | 14 | 0 | 0.066667 | 560.500 | 198.500 | 23.66565 | 2.72663 | 1
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
