Shimmer233/2026NUEDC-H/视觉/orangepi5b_vision_only/runs/manual_v4/20260802T093507Z_empty/trajectory.csv

timestamp_ns | frame_id | detected | confidence | x_px | y_px | s_cm | velocity_cm_s | predicted
1785663309760634589 | 0 | 0 |  |  |  |  |  | 0
1785663309780132893 | 1 | 0 |  |  |  |  |  | 0
1785663309801041099 | 2 | 0 |  |  |  |  |  | 0
1785663309819961325 | 3 | 0 |  |  |  |  |  | 0
1785663309836363035 | 4 | 0 |  |  |  |  |  | 0
1785663309856546457 | 5 | 0 |  |  |  |  |  | 0
1785663309876811836 | 6 | 1 | 0.050980 | 553.500 | 201.500 | 23.46271 | 0.00000 | 0
1785663309896656928 | 7 | 0 |  |  |  | 23.46271 | 0.00000 | 1
1785663309916542562 | 8 | 1 | 0.062745 | 552.500 | 193.500 | 23.42484 | -0.87595 | 0
1785663309936924023 | 9 | 1 | 0.117647 | 561.500 | 197.500 | 23.66245 | 4.14204 | 0
1785663309956843781 | 10 | 0 |  |  |  | 23.74496 | 4.14204 | 1
1785663309977131619 | 11 | 0 |  |  |  | 23.82899 | 4.14204 | 1
1785663310000809464 | 12 | 0 |  |  |  | 23.92707 | 4.14204 | 1
1785663310017038800 | 13 | 1 | 0.047059 | 560.500 | 198.500 | 23.94050 | 3.62689 | 0
1785663310037583302 | 14 | 1 | 0.031373 | 554.500 | 203.500 | 23.80254 | 1.55123 | 0
1785663310057772265 | 15 | 1 | 0.039216 | 553.500 | 195.500 | 23.69233 | 0.01981 | 0
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
