Shimmer233/2026NUEDC-H/视觉/orangepi5b_vision_only/runs/manual_v4/staged/trajectory.csv

timestamp_ns | frame_id | detected | confidence | x_px | y_px | s_cm | velocity_cm_s | predicted
1785663469778423364 | 7 | 0 |  |  |  |  |  | 0
1785663469819319578 | 9 | 0 |  |  |  |  |  | 0
1785663469842205847 | 10 | 0 |  |  |  |  |  | 0
1785663469860418789 | 11 | 0 |  |  |  |  |  | 0
1785663469879751719 | 12 | 0 |  |  |  |  |  | 0
1785663469903806102 | 13 | 0 |  |  |  |  |  | 0
1785663469918770202 | 14 | 0 |  |  |  |  |  | 0
1785663469942287632 | 15 | 1 | 0.035294 | 554.500 | 202.500 | 23.50581 | 0.00000 | 0
1785663469957726268 | 16 | 0 |  |  |  | 23.50581 | 0.00000 | 1
1785663469977820149 | 17 | 0 |  |  |  | 23.50581 | 0.00000 | 1
1785663469995574887 | 18 | 0 |  |  |  | 23.50581 | 0.00000 | 1
1785663470008046428 | 19 | 1 | 0.031373 | 560.500 | 198.500 | 23.75914 | 3.74100 | 0
1785663470027535982 | 20 | 1 | 0.043137 | 552.500 | 197.500 | 23.64778 | 1.16081 | 0
1785663470050491960 | 21 | 1 | 0.082353 | 560.500 | 196.500 | 23.75240 | 2.22823 | 0
1785663470069803307 | 22 | 0 |  |  |  | 23.79543 | 2.22823 | 1
1785663470090115061 | 23 | 0 |  |  |  | 23.84069 | 2.22823 | 1
1785663470110011486 | 24 | 0 |  |  |  | 23.88502 | 2.22823 | 1
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
