Shimmer233/2026NUEDC-H/视觉/steel_ball_pipeline/artifacts/yolov5n/results.csv

epoch | train/box_loss | train/obj_loss | train/cls_loss | metrics/precision | metrics/recall | metrics/mAP_0.5 | metrics/mAP_0.5:0.95 | val/box_loss | val/obj_loss | val/cls_loss | x/lr0 | x/lr1 | x/lr2
0 | 0.12494 | 0.029776 | 0 | 9.9502e-06 | 0.0029851 | 4.9906e-06 | 4.9906e-07 | 0.11762 | 0.035598 | 0 | 0.070811 | 0.0032432 | 0.0032432
1 | 0.092821 | 0.017391 | 0 | 0.003204 | 0.96119 | 0.0040842 | 0.0014328 | 0.092367 | 0.035348 | 0 | 0.040778 | 0.006544 | 0.006544
2 | 0.069968 | 0.015488 | 0 | 0.0033333 | 1 | 0.21905 | 0.051591 | 0.086806 | 0.034812 | 0 | 0.010713 | 0.0098118 | 0.0098118
3 | 0.055951 | 0.014294 | 0 | 0.68623 | 0.7194 | 0.76352 | 0.18936 | 0.055832 | 0.033128 | 0 | 0.0098515 | 0.0098515 | 0.0098515
4 | 0.047474 | 0.011519 | 0 | 0.84025 | 0.82985 | 0.84353 | 0.19411 | 0.057496 | 0.024486 | 0 | 0.0098515 | 0.0098515 | 0.0098515
5 | 0.043295 | 0.008983 | 0 | 0.85216 | 0.91343 | 0.95199 | 0.45361 | 0.042762 | 0.017815 | 0 | 0.009802 | 0.009802 | 0.009802
6 | 0.040494 | 0.0079982 | 0 | 0.94588 | 0.98806 | 0.99111 | 0.55279 | 0.037933 | 0.016311 | 0 | 0.0097525 | 0.0097525 | 0.0097525
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
