Shimmer233/2026NUEDC-H/视觉/steel_ball_pipeline/artifacts/yolov5n_adapted_v3/results.csv

epoch | train/box_loss | train/obj_loss | train/cls_loss | metrics/precision | metrics/recall | metrics/mAP_0.5 | metrics/mAP_0.5:0.95 | val/box_loss | val/obj_loss | val/cls_loss | x/lr0 | x/lr1 | x/lr2
0 | 0.11801 | 0.02482 | 0 | 0.00042786 | 0.12836 | 0.00026375 | 5.049e-05 | 0.099476 | 0.034824 | 0 | 0.070395 | 0.0032895 | 0.0032895
1 | 0.072577 | 0.014553 | 0 | 0.0033333 | 1 | 0.17387 | 0.029269 | 0.078986 | 0.03672 | 0 | 0.040362 | 0.00659 | 0.00659
2 | 0.057377 | 0.012248 | 0 | 0.75654 | 0.74207 | 0.7723 | 0.1964 | 0.061284 | 0.027534 | 0 | 0.010296 | 0.0098576 | 0.0098576
3 | 0.049264 | 0.0092127 | 0 | 0.9291 | 0.93433 | 0.90281 | 0.26405 | 0.049712 | 0.019436 | 0 | 0.0098515 | 0.0098515 | 0.0098515
4 | 0.043163 | 0.0070941 | 0 | 0.99632 | 0.99701 | 0.995 | 0.51713 | 0.038268 | 0.015998 | 0 | 0.0098515 | 0.0098515 | 0.0098515
5 | 0.040242 | 0.0058563 | 0 | 0.99616 | 0.99701 | 0.99291 | 0.53623 | 0.041119 | 0.016539 | 0 | 0.009802 | 0.009802 | 0.009802
6 | 0.037994 | 0.0051582 | 0 | 0.99896 | 1 | 0.995 | 0.55814 | 0.032629 | 0.013506 | 0 | 0.0097525 | 0.0097525 | 0.0097525
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
