Shimmer233/2026NUEDC-H/视觉/steel_ball_pipeline/artifacts/yolov5n_highblur/results.csv

epoch | train/box_loss | train/obj_loss | train/cls_loss | metrics/precision | metrics/recall | metrics/mAP_0.5 | metrics/mAP_0.5:0.95 | val/box_loss | val/obj_loss | val/cls_loss | x/lr0 | x/lr1 | x/lr2
0 | 0.12265 | 0.028077 | 0 | 3.9801e-05 | 0.01194 | 2.7174e-05 | 4.6744e-06 | 0.10722 | 0.035602 | 0 | 0.070667 | 0.0032593 | 0.0032593
1 | 0.091776 | 0.016852 | 0 | 0.001791 | 0.53731 | 0.0014298 | 0.00028475 | 0.099118 | 0.033373 | 0 | 0.040634 | 0.00656 | 0.00656
2 | 0.068368 | 0.014765 | 0 | 0.0033333 | 1 | 0.094436 | 0.020729 | 0.064107 | 0.038524 | 0 | 0.010568 | 0.0098277 | 0.0098277
3 | 0.05437 | 0.014055 | 0 | 0.59959 | 0.81194 | 0.75855 | 0.26664 | 0.055175 | 0.032364 | 0 | 0.0098515 | 0.0098515 | 0.0098515
4 | 0.047357 | 0.011333 | 0 | 0.94504 | 0.97534 | 0.97806 | 0.38668 | 0.050616 | 0.02399 | 0 | 0.0098515 | 0.0098515 | 0.0098515
5 | 0.041725 | 0.0093682 | 0 | 0.97633 | 0.98487 | 0.98913 | 0.53357 | 0.040813 | 0.018823 | 0 | 0.009802 | 0.009802 | 0.009802
6 | 0.040037 | 0.0080001 | 0 | 0.98651 | 0.99701 | 0.99366 | 0.58348 | 0.036441 | 0.015488 | 0 | 0.0097525 | 0.0097525 | 0.0097525
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
