Shimmer233/2026NUEDC-H/视觉/steel_ball_pipeline/artifacts/yolov5n_v4_incremental/training_results.csv

epoch | train/box_loss | train/obj_loss | train/cls_loss | metrics/precision | metrics/recall | metrics/mAP_0.5 | metrics/mAP_0.5:0.95 | val/box_loss | val/obj_loss | val/cls_loss | x/lr0 | x/lr1 | x/lr2
0 | 0.033442 | 0.004163 | 0 | 0.99926 | 0.99798 | 0.995 | 0.58308 | 0.030783 | 0.011421 | 0 | 0.070172 | 0.0033142 | 0.0033142
1 | 0.032253 | 0.003812 | 0 | 0.99769 | 0.99798 | 0.995 | 0.56872 | 0.035023 | 0.011438 | 0 | 0.04009 | 0.0065652 | 0.0065652
2 | 0.030906 | 0.0038101 | 0 | 0.99983 | 1 | 0.995 | 0.58423 | 0.030045 | 0.011274 | 0 | 0.0099254 | 0.0097338 | 0.0097338
3 | 0.030356 | 0.003792 | 0 | 0.99983 | 1 | 0.995 | 0.57115 | 0.030657 | 0.011655 | 0 | 0.0096288 | 0.0096288 | 0.0096288
4 | 0.029711 | 0.0037472 | 0 | 0.99978 | 1 | 0.995 | 0.58253 | 0.029288 | 0.011567 | 0 | 0.0096288 | 0.0096288 | 0.0096288
5 | 0.029623 | 0.0037047 | 0 | 0.99758 | 0.99798 | 0.99488 | 0.60241 | 0.02938 | 0.011338 | 0 | 0.009505 | 0.009505 | 0.009505
6 | 0.029367 | 0.0037091 | 0 | 0.9976 | 0.99798 | 0.99496 | 0.56485 | 0.03155 | 0.0114 | 0 | 0.0093813 | 0.0093813 | 0.0093813
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
