Shimmer233/2026NUEDC-H/视觉/steel_ball_pipeline/artifacts/yolov5s_highblur/results.csv

epoch | train/box_loss | train/obj_loss | train/cls_loss | metrics/precision | metrics/recall | metrics/mAP_0.5 | metrics/mAP_0.5:0.95 | val/box_loss | val/obj_loss | val/cls_loss | x/lr0 | x/lr1 | x/lr2
0 | 0.11423 | 0.021142 | 0 | 0.0023184 | 0.69552 | 0.0021035 | 0.00050823 | 0.087767 | 0.038765 | 0 | 0.070333 | 0.0032963 | 0.0032963
1 | 0.070667 | 0.016858 | 0 | 0.0035316 | 0.99701 | 0.64412 | 0.15067 | 0.059583 | 0.037458 | 0 | 0.040301 | 0.0065968 | 0.0065968
2 | 0.055719 | 0.013429 | 0 | 0.57266 | 0.72239 | 0.73427 | 0.34019 | 0.057533 | 0.034928 | 0 | 0.010235 | 0.0098643 | 0.0098643
3 | 0.050373 | 0.010942 | 0 | 0.73131 | 0.91642 | 0.85053 | 0.37036 | 0.042917 | 0.021136 | 0 | 0.0098515 | 0.0098515 | 0.0098515
4 | 0.043983 | 0.0090834 | 0 | 0.98397 | 0.98209 | 0.9945 | 0.56596 | 0.038202 | 0.022105 | 0 | 0.0098515 | 0.0098515 | 0.0098515
5 | 0.040299 | 0.0078101 | 0 | 0.8645 | 0.99403 | 0.9171 | 0.48519 | 0.034813 | 0.01596 | 0 | 0.009802 | 0.009802 | 0.009802
6 | 0.037714 | 0.0067737 | 0 | 0.99945 | 1 | 0.995 | 0.58396 | 0.034647 | 0.013897 | 0 | 0.0097525 | 0.0097525 | 0.0097525
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
