Shimmer233/2026NUEDC-H/视觉/steel_ball_pipeline/runs/final_calibration_yolov5n_adapted_v3_480x320/frames.csv

video | video_path | frame_id | expected_ball | evaluation_state | confidence | x1 | y1 | x2 | y2
normal | C:\Users\Light\Videos\final_正常往返.mp4 | 0 |  | ignore | 0.0
normal | C:\Users\Light\Videos\final_正常往返.mp4 | 1 |  | ignore | 0.0
normal | C:\Users\Light\Videos\final_正常往返.mp4 | 2 |  | ignore | 0.0
normal | C:\Users\Light\Videos\final_正常往返.mp4 | 3 |  | ignore | 0.0
normal | C:\Users\Light\Videos\final_正常往返.mp4 | 4 |  | ignore | 0.0
normal | C:\Users\Light\Videos\final_正常往返.mp4 | 5 |  | ignore | 0.0025637615472078323 | 5.146197319030762 | 42.90336227416992 | 29.117244720458984 | 66.21900939941406
normal | C:\Users\Light\Videos\final_正常往返.mp4 | 6 |  | ignore | 0.0
normal | C:\Users\Light\Videos\final_正常往返.mp4 | 7 |  | ignore | 0.001251557725481689 | 5.220086097717285 | 42.29913330078125 | 27.86174201965332 | 65.89908599853516
normal | C:\Users\Light\Videos\final_正常往返.mp4 | 8 |  | ignore | 0.0013669502222910523 | 5.307611465454102 | 42.45981979370117 | 27.918846130371094 | 65.90594482421875
normal | C:\Users\Light\Videos\final_正常往返.mp4 | 9 |  | ignore | 0.004946684930473566 | 6.333874702453613 | 45.11717987060547 | 29.141359329223633 | 67.33063507080078
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
