Shimmer233/2026NUEDC-H/视觉/steel_ball_pipeline/artifacts/yolov5n_highblur/results.png

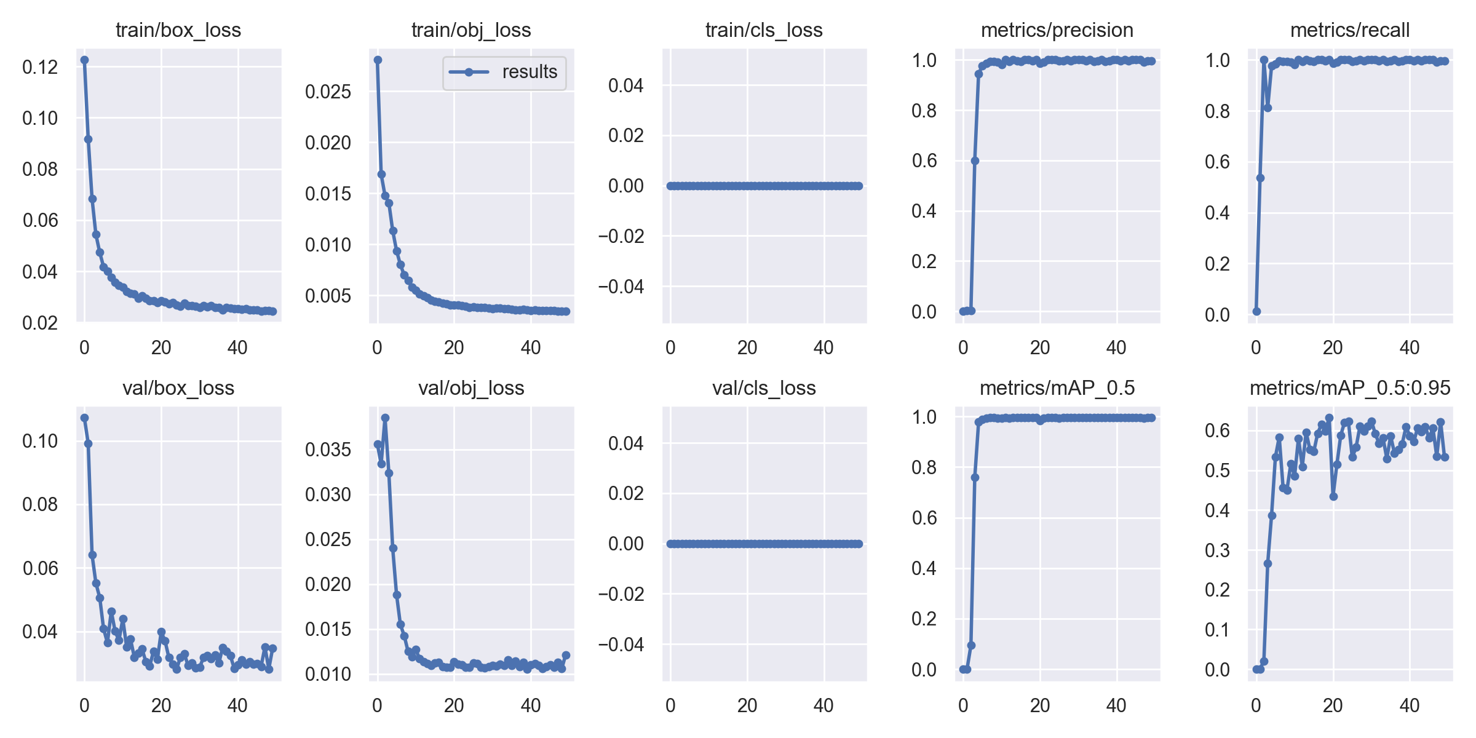
视觉/steel_ball_pipeline/artifacts/yolov5n_highblur/results.png
