Shimmer233/2026NUEDC-H/视觉/steel_ball_pipeline/artifacts/yolov5n_v4_incremental/training_results.png

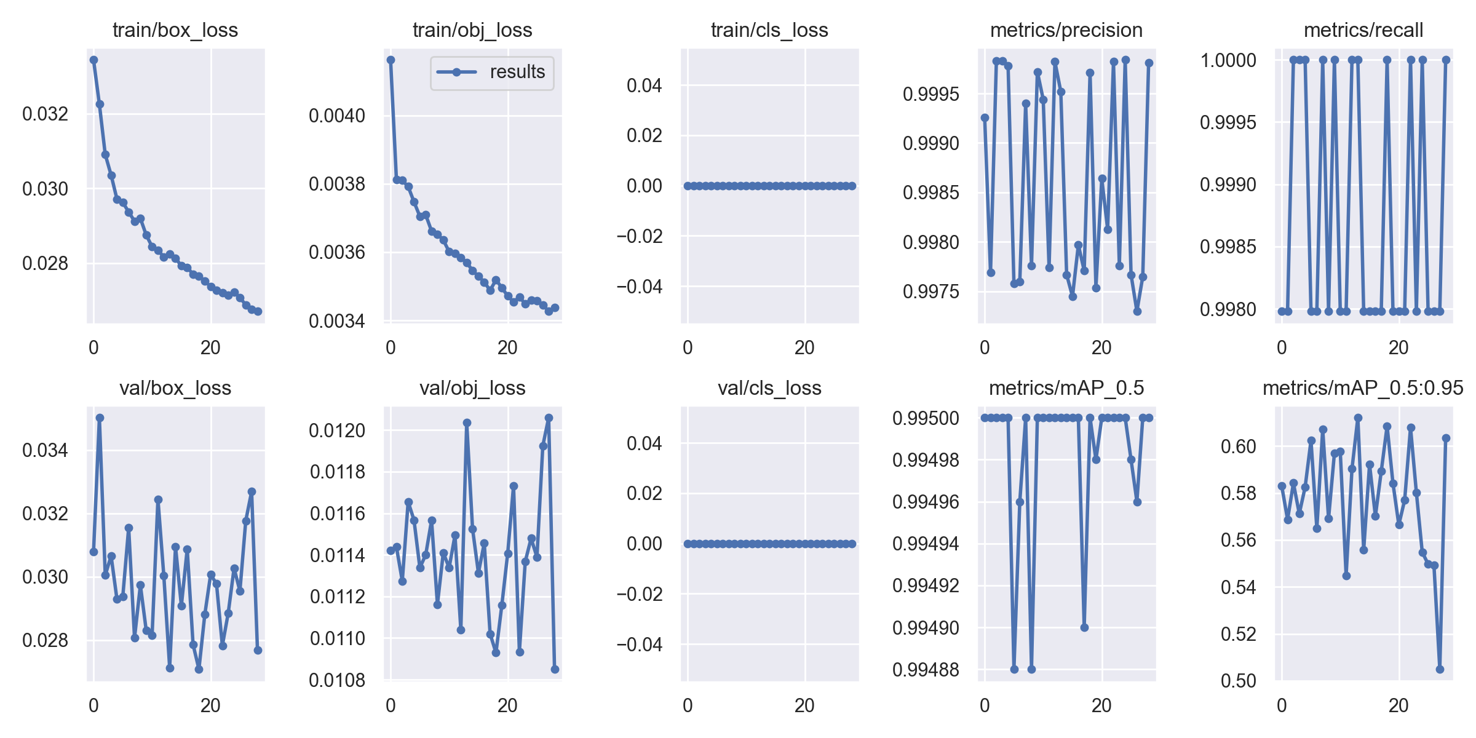
视觉/steel_ball_pipeline/artifacts/yolov5n_v4_incremental/training_results.png
