Shimmer233/2026NUEDC-H/视觉/steel_ball_pipeline/artifacts/orangepi5b_deployment_v3_final/config/board.yaml

model: models/steel_ball_yolov5n_int8.rknn
calibration: config/track_calibration.yaml
camera:
  device: /dev/video0
  width: 1280
  height: 720
  fps: 60
  fourcc: MJPG
roi:
  x: 10
  y: 140
  width: 1110
  height: 260
  output_width: 470
  output_height: 110
detection:
  input_size: 640
  confidence_threshold: 0.03
  iou_threshold: 0.45
  track_y_min: 25
  track_y_max: 85
tracking:
  process_acceleration_std: 40.0
  measurement_std_cm: 0.12
  max_prediction_frames: 3
output:
  csv: runs/board/trajectory.csv
  display: true
